Circuit-Digest/Wireless-Soil-Moisture-Sensor-with-Micro-Energy-Harvester/BOM.xlsx

Designator | Value | Package | Manufacturer | Digikey Part Number | Datasheet Link | Quantity
C1 | 10nF | C603 | KYOCERA AVX | 478-KGM15AR71H103KTCT-ND (https://www.digikey.in/en/products/detail/kyocera-avx/06035C103KAT2A/563337) | Datasheet (https://datasheets.kyocera-avx.com/KGM_X7R.pdf) | 1
C10, C11, C13, C15, C16, C3, C5, C8 | 0.1uf | C603 | Samsung Electro-Mechanics | 1276-1935-1-ND (https://www.digikey.in/en/products/detail/samsung-electro-mechanics/CL10B104KB8NNWC/3887593) | Datasheet (https://media.digikey.com/pdf/Data%20Sheets/Samsung%20PDFs/CL10B104KB8NNWC_Spec.pdf) | 8
C14 | 470pf | C603 | Walsin Technology Corporation | 1292-1438-1-ND (https://www.digikey.in/en/products/detail/walsin-technology-corporation/0603B471K500CT/9354935) | Datasheet (http://www.passivecomponent.com/wp-content/uploads/datasheet/WTC_MLCC_General_Purpose.pdf) | 1
C2, C6 | 4.7uf | C603 | Samsung Electro-Mechanics | 1276-1784-1-ND (https://www.digikey.in/en/products/detail/samsung-electro-mechanics/CL10A475KO8NNNC/3887442) | Datasheet (https://media.digikey.com/pdf/Data%20Sheets/Samsung%20PDFs/CL10A475KO8NNNC_Spec.pdf) | 2
C4 | 10uF | C603 | Murata Electronics | 490-GRM188R6YA106MA73JCT-ND (https://www.digikey.in/en/products/detail/murata-electronics/GRM188R6YA106MA73J/8346265) | Datasheet (https://search.murata.co.jp/Ceramy/image/img/A01X/G101/ENG/GRM188R6YA106MA73-01A.pdf) | 1
C7, C9 | 18pF | C603 | KEMET | 399-C0603C180K4HAC7867CT-ND (https://www.digikey.in/en/products/detail/kemet/C0603C180K4HAC7867/7946786) | Datasheet (https://connect.kemet.com:7667/gateway/IntelliData-ComponentDocumentation/1.0/download/datasheet/C0603C180K4HAC7867) | 2
D1 | LED | LED_0603 | Harvatek Corporation | 3147-B1931NB--20C007614U1930CT-ND (https://www.digikey.in/en/products/detail/harvatek-corporation/B1931NB-20C007614U1930/15861263) | Datasheet (https://media.digikey.com/pdf/Data%20Sheets/Harvatek%20PDFs/B1931NB--20C007614U1930.pdf) | 1
D2 | 1N4148WS | SOD-323 | Diodes Incorporated | 1N4148WSF-7DICT-ND (https://www.digikey.in/en/products/detail/diodes-incorporated/1N4148WSF-7/4570628) | Datasheet (https://www.diodes.com/assets/Datasheets/1N4148WSF.pdf) | 1
L1 | 22uH | IND_VLS3015CX-220M-1 | TDK Corporation | 445-181504-1-ND (https://www.digikey.in/en/products/detail/tdk-corporation/VLS3015CX-220M-1/9925357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) | Datasheet (https://product.tdk.com/en/system/files) | 1
R1, R5 | 5.9M | R0603 | Vishay Dale | 541-5.90MHCT-ND | Datasheet (https://www.vishay.com/docs/20035/dcrcwe3.pdf) | 2
R10 | 150K | R0603 | Vishay Dale | 541-150KHCT-ND (https://www.digikey.in/en/products/detail/vishay-dale/CRCW0603150KFKEA/1174914) | Datasheet (https://www.vishay.com/docs/20035/dcrcwe3.pdf) | 1
R11 | 4.7M | R0603 | Vishay Dale | 541-4.70MHCT-ND (https://www.digikey.in/en/products/detail/vishay-dale/CRCW06034M70FKEA/1175086) | Datasheet (https://www.vishay.com/docs/20035/dcrcwe3.pdf) | 1
R12 | 18M | R0603 | YAGEO | 13-RC0603JR-0718MLCT-ND (https://www.digikey.in/en/products/detail/yageo/RC0603JR-0718ML/5918442) | Datasheet (https://www.yageo.com/upload/media/product/productsearch/datasheet/rchip/PYu-RC_Group_51_RoHS_L_12.pdf) | 1
R13 | 4.7R | R0805 | Vishay Dale | 541-4.7APCT-ND (https://www.digikey.in/en/products/detail/vishay-dale/CRCW08054R70JNEAIF/3477246) | Datasheet (https://www.vishay.com/docs/20024/dcrcwife3.pdf) | 1
R14 | 330R | R0603 | Bourns Inc. | CR0603-JW-331ELFCT-ND (https://www.digikey.in/en/products/detail/bourns-inc/CR0603-JW-331ELF/2345095) | Datasheet (https://www.bourns.com/docs/product-datasheets/cr.pdf?sfvrsn=574d41f6_14) | 1
R15 | 56K | R0603 | Vishay Dale | 541-56.0KHCT-ND (https://www.digikey.in/en/products/detail/vishay-dale/CRCW060356K0FKEA/1174867) | Datasheet (https://www.vishay.com/docs/20035/dcrcwe3.pdf) | 1
R16, R18, R19, R22 | 10k | R0603 | Stackpole Electronics Inc | RNCP0603FTD10K0CT-ND (https://www.digikey.in/en/products/detail/stackpole-electronics-inc/RNCP0603FTD10K0/2240139) | Datasheet (https://www.seielect.com/Catalog/SEI-RNCP.pdf) | 6
R17 | 1k | R0603 | Stackpole Electronics Inc | RNCP0603FTD1K00CT-ND (https://www.digikey.in/en/products/detail/stackpole-electronics-inc/RNCP0603FTD1K00/2240106) | Datasheet (https://www.seielect.com/Catalog/SEI-RNCP.pdf) | 1
R2, R6 | 4.22M | R0603 | RMCF0603FT4M22CT-ND | RMCF0603FT4M22CT-ND (https://www.digikey.in/en/products/detail/stackpole-electronics-inc/RMCF0603FT4M22/6266830) | Datasheet (https://www.seielect.com/Catalog/SEI-RMCF_RMCP.pdf) | 2
R21 | 1.6K | R0603 | YAGEO | 311-1.6KGRCT-ND (https://www.digikey.in/en/products/detail/yageo/RC0603JR-071K6L/726692) | Datasheet (https://www.yageo.com/upload/media/product/productsearch/datasheet/rchip/PYu-RC_Group_51_RoHS_L_12.pdf) | 1
R23 | 1M | R0603 | Walsin Technology Corporation | 1292-WR06X105JTLCT-ND (https://www.digikey.in/en/products/detail/walsin-technology-corporation/WR06X105-JTL/13239221) | Datasheet (http://www.passivecomponent.com/wp-content/uploads/chipR/ASC_WR.pdf) | 1
R3, R7 | 6.65M | R0603 | Vishay Dale | 541-6.65MHCT-ND (https://www.digikey.in/en/products/detail/vishay-dale/CRCW06036M65FKEA/1175104) | Datasheet (https://www.vishay.com/docs/20035/dcrcwe3.pdf) | 2
R4, R9 | 3.3M | R0603 | YAGEO | 311-3.3MGRCT-ND (https://www.digikey.in/en/products/detail/yageo/RC0603JR-073M3L/726758) | Datasheet (https://www.yageo.com/upload/media/product/productsearch/datasheet/rchip/PYu-RC_Group_51_RoHS_L_12.pdf) | 2
R8 | 100K | R0603 | YAGEO | 311-100KHRCT-ND (https://www.digikey.in/en/products/detail/yageo/RC0603FR-07100KL/726889) | Datasheet (https://www.yageo.com/upload/media/product/productsearch/datasheet/rchip/PYu-RC_Group_51_RoHS_L_12.pdf) | 1
R20 | 442k | R0603 | YAGEO | 311-442KHRCT-ND (https://www.digikey.in/en/products/detail/yageo/RC0603FR-07442KL/727243) | Datasheet (https://www.yageo.com/upload/media/product/productsearch/datasheet/rchip/PYu-RC_Group_51_RoHS_L_12.pdf) | 1
Q1,Q2 | S8050 | SOT-23 | Micro Commercial Co | MMSS8050-H-TPMSCT-ND (https://www.digikey.in/en/products/detail/micro-commercial-co/MMSS8050-H-TP/2696476) | Datasheet (https://www.mccsemi.com/pdf/Products/MMSS8050(SOT-23).pdf) | 2
SC1 | Solar_Cell | Solar Cell SM141K04LV-ND | ANYSOLAR Ltd | SM141K04LV-ND (https://www.digikey.in/en/products/detail/anysolar-ltd/SM141K04LV/9990461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) | Datasheet (https://waf-e.dubudisk.com/anysolar.dubuplus.com/techsupport@anysolar.biz/O18Ae0B/DubuDisk/www/Gen3/SM141K04LV%20DATA%20SHEET%20202007.pdf) | 1
U1 | ADP5091 | LFCSP-24-1EP | Analog Devices Inc. | 505-ADP5091ACPZ-2-R7CT-ND (https://www.digikey.in/en/products/detail/analog-devices-inc/ADP5091ACPZ-2-R7/7323752) | Datasheet (https://www.analog.com/media/en/technical-documentation/data-sheets/ADP5091-5092.pdf) | 1
U2 | ATmega328-AU | TQFP-32_7x7mm_P0.8mm | Microchip Technology | ATMEGA328-AU-ND (https://www.digikey.in/en/products/detail/microchip-technology/ATMEGA328-AU/2271029) | Datasheet (https://ww1.microchip.com/downloads/en/DeviceDoc/ATmega48A-PA-88A-PA-168A-PA-328-P-DS-DS40002061B.pdf) | 1
U3 | TLC555C | SOIC-8_3.9x4.9mm_P1.27mm | Texas Instruments | 296-1336-5-ND (https://www.digikey.in/en/products/detail/texas-instruments/TLC555CD/277501) | Datasheet (https://www.ti.com/general/docs/suppproductinfo.tsp?distId=10) | 1
Y1 | 16MHz | Crystal_3225 | YIC | 3155-16M18PX/XT324-10/10CT-ND (https://www.digikey.in/en/products/detail/yic/16M18PX-XT324-10-10/13980829) | Datasheet (https://www.yic.com.tw/wp-content/uploads/2019/05/YIC-XT324.pdf) | 1
X3 | SCMT22D505PRBB0 | SCMT22D505PRBB0 | KYOCERA AVX | SCMT22D505PRBB0-ND (https://www.digikey.in/en/products/detail/kyocera-avx/SCMT22D505PRBB0/8028701) | Datasheet (https://datasheets.kyocera-avx.com/AVX-SCM.pdf) | 1
