Circuit-Digest/Wireless-Soil-Moisture-Sensor-with-Micro-Energy-Harvester/Schematics.pdf

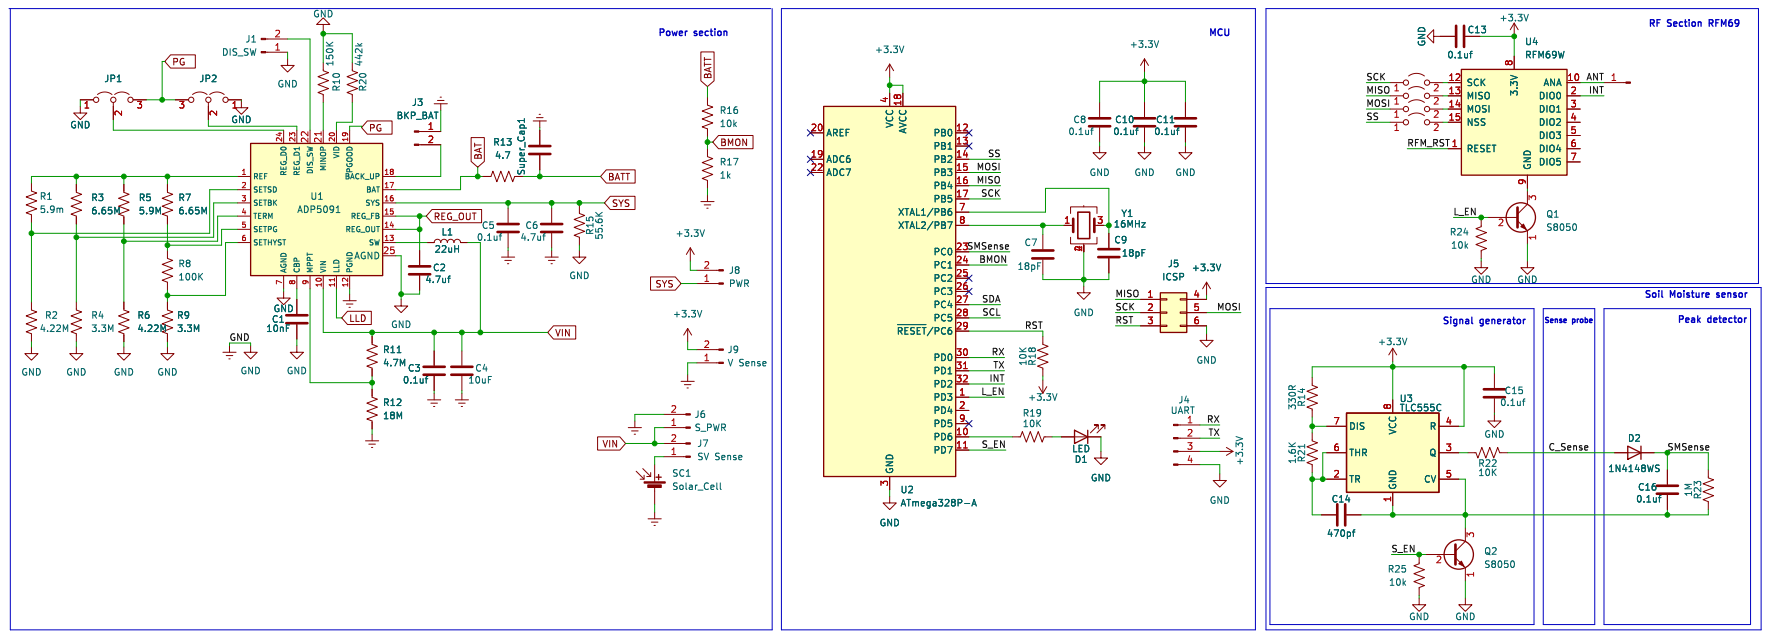
[picture p2: page 1]
